ncrmro/ks-systems-hardware/modules/components/ram.scad

// A module for a single DDR4 RAM stick
module ram_stick() {
    ram_l = 133.35;
    ram_h = 31.25;
    ram_t = 1.2;
    cube([ram_l, ram_t, ram_h]);
}
