ncrmro/ks-systems-hardware/modules/case/base/base_assembly.scad

// Base assembly: bottom panel + standoffs + feet
// This is the foundation that all case configurations build upon
//
// Components:
// - Bottom panel with integrated standoff receptacles (hexagonal recesses)
// - Extended standoffs (M3x10+6mm male-female) positioned in receptacles
// - Rubber feet (optional, screw into #6-32 corner holes)
//
// The integrated bottom panel design eliminates the need for a separate
// motherboard plate. Standoffs mount directly into hexagonal recesses
// and are secured by M3 screws from underneath.
//
// Usage in assemblies:
//   translate([wall_thickness, wall_thickness, wall_thickness]) {
//       base_assembly(show_feet = true);
//   }

include <../dimensions_minimal.scad>
use <../panels/standard/bottom.scad>
use <../frame/standoff_extended.scad>

module base_assembly(
    panel_width = exterior_panel_width,
    panel_depth = exterior_panel_depth,  // 173mm - extends to cover back panel
    standoff_x_offset = wall_thickness   // Offset standoffs to align with motherboard
) {
    union() {
        // Bottom panel with integrated standoff receptacles
        bottom_panel(width = panel_width, depth = panel_depth);

        // Extended standoffs positioned on top of bottom panel
        // The hexagonal boss is a structural feature on the panel for screw retention
        // Standoffs sit on the panel top surface at Z = wall_thickness (3mm)
        // X offset added to align with motherboard (which is at X=wall_thickness in assembly)
        echo("=== BASE ASSEMBLY DEBUG ===");
        echo("Rendering", len(standoff_locations), "standoffs with X offset=", standoff_x_offset);
        for (loc = standoff_locations) {
            echo("Standoff at X=", loc[0] + standoff_x_offset, "Y=", loc[1], "Z=", wall_thickness);
            translate([loc[0] + standoff_x_offset, loc[1], wall_thickness]) {
                extended_standoff();  // Correct module name from standoff_extended.scad
            }
        }
    }
}

// Preview
base_assembly();
