ncrmro/ks-systems-hardware/modules/case/panels/standard/front.scad

// Front panel for minimal/barebones configuration
// Features power button hole and optional LED/USB cutouts
// Parametric: accepts width and height for different configurations

include <../../dimensions_minimal.scad>

module front_panel(
    width = front_back_panel_width + 2 * wall_thickness,
    height = front_back_panel_height
) {
    // Panel dimensions (extended 3mm each side to cover side panel gap)
    panel_width = width;
    panel_height = height;
    panel_thickness = wall_thickness;        // 3mm

    // Power button (typical 12mm momentary switch)
    power_btn_diameter = 12;
    power_btn_x = 30;  // Left side of panel
    power_btn_z = panel_height / 2;

    // Power LED hole
    power_led_diameter = 3;
    power_led_x = power_btn_x + 20;
    power_led_z = power_btn_z;

    // HDD activity LED hole
    hdd_led_diameter = 3;
    hdd_led_x = power_led_x + 10;
    hdd_led_z = power_btn_z;

    // Panel height (matches case exterior height)
    actual_panel_height = panel_height;  // No extension needed with new panel hierarchy

    // Raised lip dimensions
    lip_height = wall_thickness;      // 3mm
    lip_depth = wall_thickness;       // 3mm (protrudes into case)
    lip_z_offset = wall_thickness;    // 3mm from bottom

    color("gray") {
        union() {
            difference() {
                cube([panel_width, panel_thickness, actual_panel_height]);

            // Power button hole
            translate([power_btn_x, -0.1, power_btn_z]) {
                rotate([-90, 0, 0]) {
                    cylinder(h = panel_thickness + 0.2, d = power_btn_diameter, $fn = 30);
                }
            }

            // Power LED hole
            translate([power_led_x, -0.1, power_led_z]) {
                rotate([-90, 0, 0]) {
                    cylinder(h = panel_thickness + 0.2, d = power_led_diameter, $fn = 20);
                }
            }

            // HDD activity LED hole
            translate([hdd_led_x, -0.1, hdd_led_z]) {
                rotate([-90, 0, 0]) {
                    cylinder(h = panel_thickness + 0.2, d = hdd_led_diameter, $fn = 20);
                }
            }
            }

            // Bottom lip (protrudes backward into case, inset 3mm from sides)
            translate([wall_thickness, panel_thickness, lip_z_offset]) {
                cube([panel_width - 2 * wall_thickness, lip_depth, lip_height]);
            }

            // Top lip (protrudes backward into case, inset 3mm from sides)
            // Positioned relative to panel height to work with all configurations
            translate([wall_thickness, panel_thickness, panel_height - wall_thickness - lip_height]) {
                cube([panel_width - 2 * wall_thickness, lip_depth, lip_height]);
            }
        }
    }
}

// Preview
front_panel();
