ncrmro/ks-systems-hardware/modules/case/panels/standard/side_pico_right.scad

// Right side panel for Pico configuration - STL export file
use <side_pico.scad>

side_panel_pico(side = "right");
