ncrmro/ks-systems-hardware/(list of files, cad)

Other CAD files:
modules/components/motherboard/motherboard.scad
assemblies/gpu_aio.scad
modules/components/cooling/fan_120mm_15mm.scad
modules/case/panels/gpu/side_right.scad
modules/case/panels/standard/bottom_pico.scad
tests/base_assembly_dovetail_pico.scad
modules/util/dovetail/test_jig.scad
