ncrmro/ks-systems-hardware/(commit log)

2025-11-23 chore: initial commit
    [test.scad]
2025-11-23 feat: add honyecomb pattern
    [test.scad]
2025-11-25 refactor: into modules
    [case.scad, cpu_cooler.scad, honeycomb.scad, mini.scad, motherboard.scad, ram.scad, test.scad]
2025-11-27 feat: check in modules and components
    [aio_pump.scad, aio_radiator_240.scad, backplate_io.scad, bottom.scad, bracket.scad, case.scad, cpu_cooler.scad, dimensions.scad]
2025-11-27 chore: create proper flex orintation
    [psu_flex_atx.scad]
2025-11-28 chore: checking
    [backplate_io.scad, bottom.scad, case.scad, dimensions.scad, frame.scad, front.scad, hotswap_rails.scad, minimal.scad]
2025-11-28 feat: create internal chamber height and backplate cutout
    [backplate_io.scad, dimensions.scad, minimal.scad, nas_2disk.scad]
2025-11-28 chore: unify flex psu dimensions
    [backplate_io.scad, bottom.scad, component_viewer.scad, dimensions.scad, frame.scad, minimal.scad, nas_2disk.scad, psu_flex_atx.scad]
2025-11-30 refactor: back panel
    [back.scad, dimensions.scad, mini-nas.scad, mini.scad, minimal.scad, nas_2disk.scad, nas_many.scad]
2025-11-30 feat: open air frame, rapid panel mounting syste, and directed air top panel
2025-11-30 chore: more psu
    [back.scad, dimensions.scad, psu_flex_atx.scad]
2025-11-30 feat: add barrel jack and extended
    [barrel_jack_5_5x2_5.scad, standoff_extended.scad]
2025-11-30 refactor: create motherboard component assembly
    [mini-nas.scad, mini.scad, minimal.scad, motherboard.scad, nas_2disk.scad, nas_many.scad]
2025-11-30 feat: add detailed Noctua NH-L12S CPU cooler model
    Add detailed component breakdown of NH-L12S cooler:
    - CPU base plate (5mm)
    - Heatpipes (30mm)
    - 120mm x 15mm fan (NF-A12x15)
    - Heatsink fins (20mm)
    Total height: 70mm (base + fan + fins)
    Refactor cpu_cooler.scad to use modular components while
    maintaining backward compatibility through wrapper module.
    Add shared dimensions to dimensions.scad:
    - cooler_base_height, cooler_fan_height, cooler_fins_height
    - Replace single cooler_heatsink_height with component breakdown
    [cpu_base.scad, dimensions.scad, fan_120mm_15mm.scad, heatpipes.scad, heatsink.scad, heatsink_fins.scad]
2025-11-30 feat: add extended standoffs to motherboard model
    Add extended standoffs at Mini-ITX mounting locations:
    - 6mm female portion below PCB
    - 10mm male stud extending up through mounting holes
    - M3 clearance holes in motherboard PCB
    Update motherboard_assembly.scad to rotate cooler 90° CCW
    and reposition to stay over CPU area (fits within RAM cutout).
    [motherboard.scad]
2025-11-30 feat: add open air frame components (cylinders and upper frame)
    Add frame_cylinder.scad:
    - Free-floating cylinder with internal M3 thread
    - Height derived from interior_chamber_height (~86mm)
    - 8mm outer diameter, 3.2mm inner clearance
    - 10mm thread depth for extended standoff male stud
    Add upper_frame.scad:
    - Structural frame holding 4 cylinders at motherboard corners
    - Retention lips on cylinders to prevent upward movement
    - Provides foundation for rapid panel mounting system
    Add dimensions to dimensions.scad:
    - frame_cylinder_height, outer/inner diameter, thread depth
    [frame_cylinder.scad, upper_frame.scad]
2025-11-30 feat: add raised lips to front and side panels for frame mounting
    Update front_panel.scad:
    - Extend width +6mm to cover side panel gaps
    - Extend height +3mm (raised positioning)
    - Add bottom and top lips (3mm high, 3mm deep) for cylinder engagement
    Update side_panel_left.scad:
    - Shorten depth -3mm from front (173mm)
    - Add bottom and top lips (3mm high, 3mm deep) for cylinder engagement
    - Lips inset 6mm from edges to avoid interference
    Lips provide mechanical interface with frame cylinders
    for rapid panel mounting system.
    [front.scad, side_left.scad]
2025-11-30 feat: integrate frame components and update panel positioning in assemblies
    Update minimal.scad:
    - Adjust front panel to X=0 (extended to cover sides)
    - Adjust side panels to Y=wall_thickness (offset from front)
    - Adjust top panel to Z=minimal_exterior_height (on top of raised panels)
    Update nas_2disk.scad:
    - Add frame_cylinders and upper_frame components
    - Add show_frame_cylinders and show_upper_frame toggle flags
    - Update panel positioning to match minimal.scad changes
    Panel positioning now accounts for raised lips and frame system.
    [minimal.scad, nas_2disk.scad]
2025-11-30 chore: update TASKS.md to reflect completed frame components
    Mark as complete:
    - Phase 7.2: Frame cylinder (✅)
    - Phase 7.3: Upper frame structure (✅)
    Update file status in directory structure:
    - frame_cylinder.scad: ❌ → ✅
    - upper_frame.scad: ❌ → ✅
    Add implementation notes for completed components.
2025-11-30 docs: expand CLAUDE.md with comprehensive project documentation
    Add detailed information from SPEC.md and codebase analysis:
    - Expand project overview with specific config details (dimensions, PSU orientation, GPU requirements)
    - Document all shared dimensions from dimensions.scad (standoffs, PSU, HDD, frame components)
    - Add coordinate system conventions and assembly positioning patterns
    - Document modular frame system (base + NAS stacking, #6-32 mounting)
    - Detail open air frame components (extended standoffs, frame cylinders, upper frame)
    - Explain panel features (raised lips, extended dimensions, mounting holes)
    - Document cooling and airflow strategies for each configuration
    - Add comp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
2025-12-07 refactor: back plate
    [base_assembly.scad, bottom.scad, dimensions.scad, gpu.scad, gpu_aio.scad, minimal.scad, motherboard.scad, nas_2disk.scad]
2025-12-08 feat: remove feed and bottom holes for now, create pico formfactor
    [back_pico.scad, base_assembly.scad, bottom.scad, cpu_cooler_nh_l9.scad, dimensions.scad, dimensions_pico.scad, front.scad, minimal.scad]
2025-12-08 fix: pico psu dimensions
    [psu_pico.scad]
2025-12-08 fix: pico motherboard assembly
    [pico.scad]
2025-12-08 refactor: motherboard componnets
    [component_viewer.scad, gpu.scad, gpu_aio.scad, minimal.scad, motherboard.scad, motherboard_full_minitx.scad, motherboard_full_pico.scad, motherboard_with_ram.scad]
2025-12-08 fix: atx power connector positioning
    [atx_24pin_connector.scad, motherboard.scad]
2025-12-08 refactor: extract shared dimensions into base file
    - Create dimensions_minimal.scad for minimal/NAS config-specific vars
    - Refactor dimensions.scad to contain only shared Mini-ITX specs
    - Update dimensions_pico.scad to include base dimensions.scad
    - Create dedicated pico bottom panel and base assembly
    - Fix bottom panel standoff hex pockets (now have holes)
    - Update standoff locations to match real Mini-ITX measurements
    - Update standoff hex size to 5mm flat-to-flat
    - Update all 30+ files to use appropriate dimension file
    This eliminates duplicate variable definitions between configs.
    Shared dimensions now only need to be changed in one place.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
    [back.scad, backplate_io.scad, base_assembly.scad, base_assembly_pico.scad, bottom.scad, bottom_pico.scad, bracket.scad, case.scad]
2025-12-09 fix: mini atx standoff hole positioning and add optional hole for quick printing
    [bottom.scad, bottom_pico.scad, dimensions.scad]
2025-12-09 chore: get pannels to be the correct height
    [back.scad, back_pico.scad, base_assembly.scad, base_assembly_pico.scad, bottom.scad, bottom_pico.scad, dimensions_minimal.scad, dimensions_pico.scad]
2025-12-10 chore: add pico barrle jack to back plane
    [barrel_jack_5_5x2_5.scad, dimensions_pico.scad, pico.scad]
2025-12-10 feat: integrate dovetail joints for base assembly
    Add dovetail joint system for tool-free panel joining:
    - Extract dovetail modules from spike (dimensions, male, female)
    - Add female dovetails to bottom panel back edge
    - Add male dovetails to back panel bottom edge
    - Update pico variants with same dovetail integration
    - Add test assemblies for verifying dovetail fit
    Per SPEC.md Section 9.6 - Base Assembly (Back + Bottom)
    [back.scad, back_pico.scad, base_assembly_dovetail.scad, base_assembly_dovetail_pico.scad, bottom.scad, bottom_pico.scad, dimensions.scad, female_dovetail.scad]
2025-12-12 feat: add screenshots script and upload to r2
    [back.scad, back_pico.scad, minimal.scad, nas_2disk.scad, nas_many.scad, pico.scad]
2025-12-12 docs: add README with project overview and gallery
    Includes configuration table, assembly screenshots from R2,
    usage instructions, and project structure overview.
2025-12-12 feat: correctly psoition dovetails on back panel
    [back.scad, back_pico.scad]
2025-12-12 chore: update dovetail dimensions
    [dimensions.scad, pico.scad]
2025-12-12 docs: update spec with two-shell assembly design and add Pico phase
    - Refine Section 9 (Panel Construction) with two-shell concept:
    - Bottom shell: bottom + back panels (semi-permanent)
    - Top shell: top + front + sides (internal dovetail clips)
    - Non-locking dovetails for structural alignment
    - User-accessible back panel clips for case opening
    - Update panel edge assignments with clip vs non-locking types
    - Add Y-axis sliding case open/close procedure
    - Add Phase 7: Dovetail Joint System modules
    - Add Phase 8: Pico Configuration (ultra-compact 176x176x63mm)
    - Add NH-L9 cooler and barrel jack to components TODO
    - Update directory structure for dovetails and pico panels
    🤖 Generated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
2025-12-12 feat: add top panel with outward-facing dovetails for pico config
    Top panel features ventilation honeycomb over CPU area and female
    clip dovetails on front/left/right edges for two-shell assembly.
    [top_pico.scad]
2025-12-12 fix: inset top panel side dovetails for flush side panel fit
    Move left/right edge dovetails inward by wall_thickness so side
    panels can fit flush against the top panel edges.
    [top_pico.scad]
2025-12-12 fix: reduce back panel to single clip per side
    Changed from two clips (33%/67%) to one clip (50%) per side edge
    for simpler release mechanism.
    [back_pico.scad]
2025-12-12 feat: consolidate pico panels with dovetail joints
    - Add unified side_pico.scad with side parameter ("left"/"right")
    - Add front_pico.scad with dovetails for two-shell assembly
    - Add dovetail test_jig.scad for print validation
    - Update back_pico.scad: extend to full width, center features
    - Update bottom_pico.scad: remove side edge dovetails
    - Simplify dovetail connections: single clip per back panel side
    - Update assembly positioning for full-width back panel
    [back_pico.scad, bottom_pico.scad, front_pico.scad, pico.scad, side_pico.scad, test_jig.scad]
2025-12-12 feat: add female_dovetail_pocket module with integrated shelf
    Creates a reusable component combining the female dovetail with a top
    shelf for external mounting on panel edges. The shelf:
    - Attaches to top of dovetail boss
    - Extends wall thickness beyond dovetail on each side (width)
    - Covers full dovetail depth plus wall thickness on closed side
    - Stays flush with opening for male dovetail insertion
    [female_dovetail_pocket.scad]
2025-12-12 feat: add dovetail pockets to sidepanel
    [side_pico.scad]
2025-12-12 fix: mirror right side panel so exterior faces outward
    Refactored side_panel_pico module to use internal mirror() for right
    side panels instead of duplicated left/right dovetail positioning code.
    The honeycomb ventilation now correctly faces outward on both sides.
    [side_pico.scad]
2025-12-12 refactor: remove front panel dovetail connections
    Removed dovetails that connected front panel to bottom and side panels:
    - front_pico.scad: removed bottom edge dovetails
    - bottom_pico.scad: removed front edge dovetails
    - side_pico.scad: removed front edge dovetails
    Front panel now only connects to top panel via top edge dovetails.
    [bottom_pico.scad, front_pico.scad, side_pico.scad]
2025-12-12 fix: position front panel dovetails flush and beneath top edge
    Adjusted dovetail positioning:
    - Y position: panel_thickness + dovetail_length/2 (back edge flush with inside face)
    - Z position: panel_height - dovetail_height - wall_thickness (beneath top edge)
    - Rotation: [0, 0, 0] (extending along +Y axis into case)
    [front_pico.scad]
2025-12-12 feat: front dovetails
    [front_pico.scad]
2025-12-13 refactor: simplify side panel geometry and add STL export files
    - Remove top retention lip from side panel
    - Raise top edge dovetails to be flush with panel top
    - Remove rear extension tongues (nibs) from side panel
    - Remove corresponding retention lip slots from back panel
    - Lower bottom retention lip to be flush with floor
    - Shorten bottom lip to avoid front panel overlap
    - Add side_pico_left.scad and side_pico_right.scad for easy STL export
    [back_pico.scad, side_pico.scad, side_pico_left.scad, side_pico_right.scad]
2025-12-13 chore: clean up all panel dovtails
    [bottom_pico.scad, front_pico.scad, pico.scad, pico_bottomshell.scad, pico_topshell.scad, top_pico.scad]
2025-12-14 feat: add release script
    [info_embosser.scad]
2025-12-14 feat: add SSD harness with screw channels to pico top panel
    - Add 2.5" SSD component with SFF-8201 mounting hole dimensions
    - Add SSD divider walls to top panel with screw channels at standard
    mounting positions (14mm and 90.6mm from front edge)
    - Remove back-left dovetail from top/back panels for SSD clearance
    - Position SSDs in diagonal corners (back-left, front-right)
    - Channels allow M3 screws to accommodate different SSD heights
    [back_pico.scad, pico_topshell.scad, ssd_2_5.scad, top_pico.scad]
2025-12-14 refactor: sync dovetail positions with lengths and reduce honeycomb area
    - Convert all top panel edge dovetails to 9mm latchless design
    - Add synced position/length variables to prevent misalignment
    - Update front panel top edge dovetails to match (9mm latchless)
    - Reduce honeycomb vent to cover only NH-L9 cooler area (70x68mm)
    - Remove solid blocks under dovetail positions
    - Enable SSD divider in top panel preview
    [front_pico.scad, top_pico.scad]
2025-12-14 chore: tweak info embosser to actually print when converted to stl
    [info_embosser.scad]
2025-12-14 chore: reduce dovetail boss margin
    [dimensions.scad, pico.scad, pico_topshell.scad]
2025-12-14 feat: ssd harndess
    [back_pico.scad, dimensions_pico.scad, front_pico.scad, side_pico.scad, top_pico.scad]
2025-12-15 chore: adjust again
    [dimensions.scad, dimensions_pico.scad, top_pico.scad]
2025-12-15 feat: Migrate to Python/AnchorSCAD for CAD generation
    This commit introduces a major architectural shift by migrating the CAD generation
    workflow from raw OpenSCAD to a Python-based AnchorSCAD system. This change
    enhances modularity, testability, and automation for design and rendering.
    Key changes include:
    - Replaced the legacy OpenSCAD build system with a new Python-driven Generating 1 parts to /home/ncrmro/code/ncrmro/keystone-hardware/build...
    SCAD OK: test_mobo_assembly
    Rendering STLs (16 jobs)...
    STL OK: test_mobo_assembly.stl script.
    - Introduced and for Python dependency management.
    - Migrated core design logic and components to using AnchorSCAD.
    - Updated to reflect new project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
2025-12-16 feat: add initial noctua heatsink with render, test and watch ommands
2025-12-16 feat(pico): add pico case assembly and sub-assemblies
2025-12-16 fix: pico psu location
2025-12-17 refactor: directories to split lib and assemblies into their own parts
2025-12-25 Update TODO comment for SFX power supply parts
2025-12-30 chore: Setup Nix flake, direnv, and GitHub CI (#2)
    * feat: add Nix flake dev shell, direnv, and GitHub CI
    - Add flake.nix with dev shell including Python 3.13, uv, and OpenSCAD
    - Add .envrc for seamless direnv integration with nix-direnv
    - Add GitHub Actions CI workflow that runs pytest in Nix environment
    - Update .gitignore to exclude .direnv/ and Nix result symlinks
    * ci: use bin/test and add devShell build step
    - Update .github/workflows/ci.yml to use ./bin/test for standard testing
    - Add 'Build devShell' step to CI to ensure environment isolation
    - Include flake.lock and local agent settings
    - Refactor Pico case parts with dovetail support and improved centering
    * ci: add screenshot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
2026-02-09 feat(screenshots): multi-angle rendering + camera clipping fix (#4)
    * feat(screenshots): multi-angle rendering + camera clipping fix
    Replace fixed camera distance (900) with --autocenter --viewall for all
    renders, fixing clipping on larger models (GPU, NAS). Add 6 camera angles
    (iso, front, back, top, right, left) and CLI filter/--all/--angles args.
    * Update AGENTS.md
    ---------
2026-02-26 refactor: modernize to cadeng conventions
    Rename src/lib/ → src/vitamins/, src/parts/ → src/components/,
    and src/parts/components.py → src/components/mocks.py to match
    the cadeng framework naming. Modernize registry to store
    (factory, part_type) tuples, add --list-json to bin/render,
    add cadeng.yaml for gallery integration, add cadeng flake input,
    rename project to ks-systems-hardware, and gitignore .worktrees/.
2026-03-03 chore: add Makefile with cad, test, render targets
2026-03-03 chore: update cadeng — remove registry_command (cadeng.yaml is sole source of truth)
    cadeng server no longer cross-validates against the Python registry.
    Removed the now-invalid registry_command field and updated flake.lock
    to cadeng 1eca42f.
2026-03-03 feat: move back wall to base panel with IO shield cutout and barrel jack (#5)
    - PicoBasePanel now builds an L-shaped piece: flat plate + back wall
    - Back wall includes IO shield cutout and barrel jack hole
    - PicoTopShell is now open-back (no rear wall or barrel jack)
    - Add with_hdd parameter to PicoBasePanel for HDD variant height
    - Add pico_base_assembly: base panel + motherboard (no shell)
    - Add pico_base_panel_hdd model to cadeng.yaml
    - Remove unused dovetail component
2026-03-04 fix: dovetail position (#6)
    * feat: split back panel with dovetail joints and snap-fit latch retention
    - New PicoBackPanel: separate back wall with IO shield cutout, barrel jack,
    male dovetails, and latch ledges
    - PicoBasePanel: female dovetails on back edge, latch ledges on front edge
    - PicoTopShell: latch arms on front wall and back edge underside
    - New dovetail.py: FemaleDovetail (open -Y channel) + MaleDovetail (center slot)
    - New latch.py: LatchArm (flex snap-fit) + LatchLedge
    - Assembly updated to 3-piece design with exploded view support
    * fix(pico): flush male dovetails with back panel wall
    Remove 4.15mm gap between male d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
2026-06-02 docs(contributor): add slim CONTRIBUTOR.md and wire AGENTS/README
